monkeyboyfr3sh/Music-Lamps/README.md

# Music-Lamps
This started orignally as a spin-off of Natural-Nerds SoundReactive Project that has kinda become my pet project!
