monkeyboyfr3sh/Music-Lamps/Music Lamps/Documentation/Audio Visualization Poster.pdf

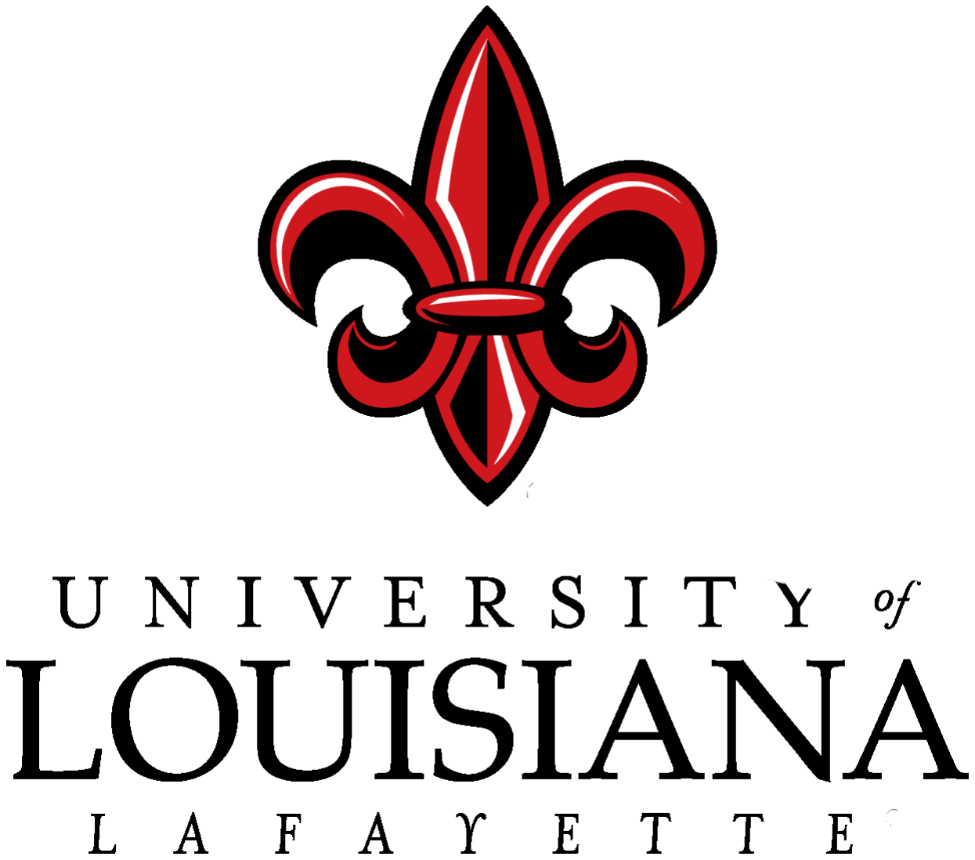
[picture p1: figure]

# Audio Visualization Over Wi-Fi Using ESP8266 and WS2812B LEDs

What is an ESP8266?

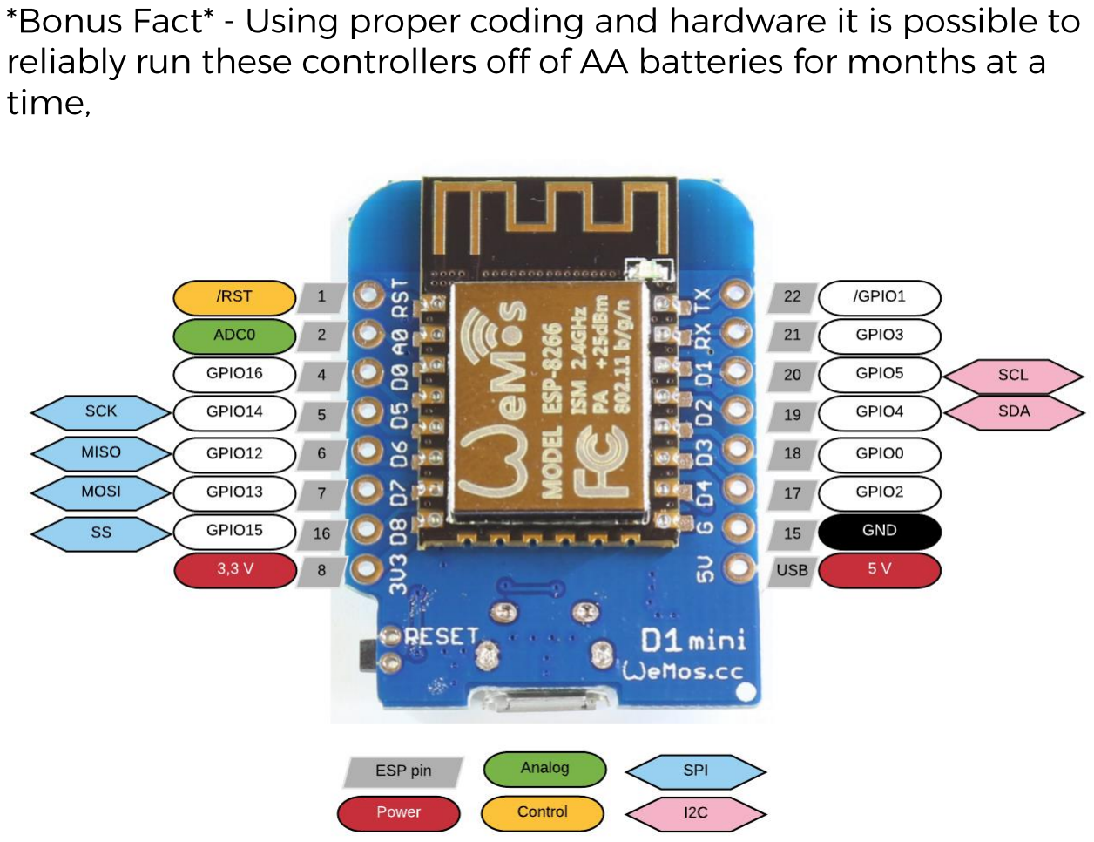
[picture p2: figure]

What are WS2812B LEDs?

Project Goal

Specifications

Difficulties Encountered

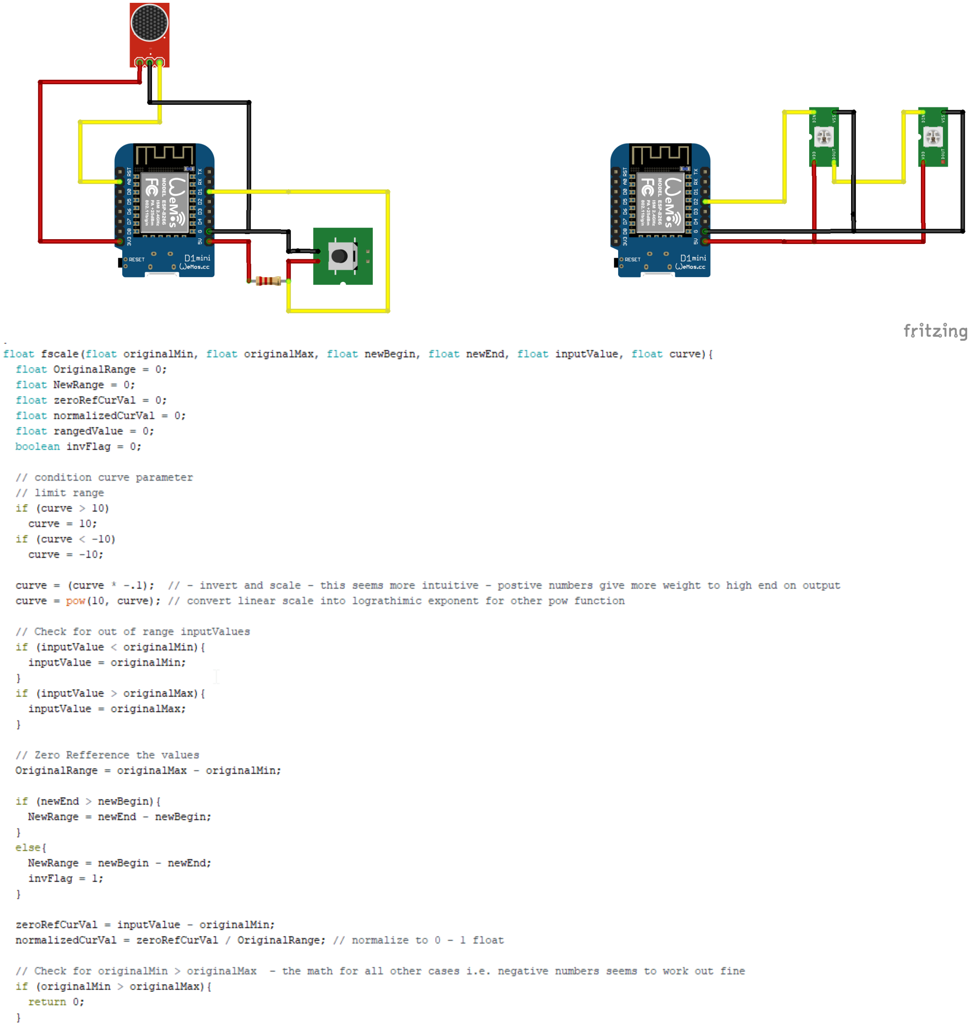
[picture p3: figure]

Future Goals

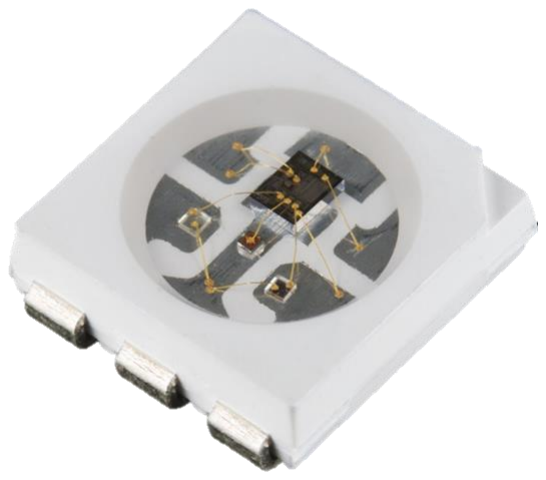
[picture p4: figure]

In Conclusion

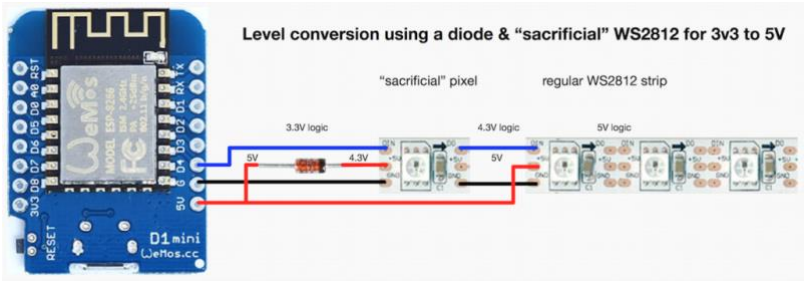
[picture p5: figure]
