monkeyboyfr3sh/Music-Lamps/Music Lamps/Expense Report.xlsx

 | Item | Link | Price | Ordered | Received | Price Paid | Count | Shipping/Insurance
1 |  |  |  |  |  | $0.00 | 0 | $0.00
2 | Power Rocker | https://www.ebay.com/itm/5-x-Mini-Rocker-Switch-Round-Black-20mm-2-Pin-SPST-Power-ON-OFF-12V-110V-220V/110776539898 | $1.39 | ebay |  | $1.79 | 1 | $0.00
3 | Battery Box Holder | https://www.banggood.com/5pcs-DIY-Battery-Box-Holder-Case-For-18650-Rechargeable-Battery-p-965083.html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 | $3.15 | Amazon |  | $0.90 | 10 | $0.00
4 | BMS/Charge Board | https://www.banggood.com/5-Pcs-TP4056-Micro-USB-5V-1A-Lithium-Battery-Charging-Module-Board-TE585-Lipo-Charger-p-1255762.html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 | $3.47 | BG |  | $3.47 | 1 | $2.01
5 | WS2812B | https://www.banggood.com/WS2812B-5050-RGB-LED-Changeable-Strip-1M-144-Leds-Non-waterproof-https://www.amazon.com/gp/product/B07BTTY4FL?ID=518492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 | $17.88 | Amazon |  | $17.88 | 3 | $0.00
6 | Power Supply | https://www.amazon.com/gp/product/B01MT5WVCG/ref=ppx_yo_dt_b_asin_title_o02_s00?ie=UTF8&psc=1 | $15.90 | Amazon |  | $15.90 | 2 | $0.00
7 | uController w/ WiFi Module | https://www.banggood.com/WeMos-D1-mini-V2_2_0-WIFI-Internet-Development-Board-Based-ESP8266-4MB-FLASH-ESP-12S-Chip-p-1143874.html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 | $2.99 | BG |  | $2.99 | 4 | $2.63
8 | DC Jack | https://www.banggood.com/10Pcs-3A-DC-Jack-Socket-Plug-Female-Panel-Mount-Power-Connector-Adapters-p-1121956.html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 | $3.39 | BG |  | $3.39 | 1 | $0.00
9 | Microphone | https://www.amazon.com/gp/product/B07L3QWBPX/ref=ppx_yo_dt_b_asin_title_o01_s00?ie=UTF8&psc=1 | $9.99 | Amazon |  | $9.99 | 2 | $0.00
 |  |  |  |  |  | $0.00 | 0 | $0.00
 |  |  |  |  |  | $0.00 | 0 | $0.00
 |  |  |  |  |  | $0.00 | 0 | $0.00
 |  |  |  |  |  | $0.00 | 0 | $0.00
 |  |  |  |  |  | $0.00 | 0 | $0.00
 |  |  |  |  |  | $0.00 | 0 | $0.00
 |  | Total: | $55-80 |  | Sub Total: | $135.02 | Shipping: | $4.64
 |  |  |  |  | Grand Total: | $139.66
