monkeyboyfr3sh/Music-Lamps/Music Lamps/ESP32 Box(Newer Software Versions)/MQTT Testing/ESP32_Master_MQTT/reactive_common.h

struct averageCounter{
  uint16_t *samples;
  uint16_t sample_size;
  uint8_t counter;

  averageCounter(uint16_t size) {
    counter = 0;
    sample_size = size;
    samples = (uint16_t*) malloc(sizeof(uint16_t) * sample_size);
  }

  bool setSample(uint16_t val) {
    if (counter < sample_size) {
      samples[counter++] = val;
      return true;
    }
    else {
      counter = 0;
      return false;
    }
  }

  int computeAverage() {
    int accumulator = 0;
    for (int i = 0; i < sample_size; i++) {
      accumulator += samples[i];
    }
    return (int)(accumulator / sample_size);
  }

};

struct heartbeat_message {
  uint32_t client_id;
  uint32_t chk;
};
